tut66/Immersive-Design-Group-MIT-project/8 Motors V2/Read me.txt

2024-9-11 出现的问题
1. 电源输入的端子太细了，需要换接口，换成pin的那个双头的端子
2. 24-5V接电感的线没有连起来，24V和5V的LED灯的线都没有接
3. M4的M4A1接线没有接到焊盘上
