tut66/Immersive-Design-Group-MIT-project/8 Motors V2/Project Outputs for 8 Motors/8 Motors_BOM.xlsx

Comment | Description | Designator | Footprint | LibRef | Quantity | Supplier Part
10nF | 0603电容 | C1, C2, C3, C19, C20, C21, C37, C38 | C0603 | C0603_10nF | 8 | C100042
100nF | 0603电容 | C4, C5, C6, C7, C8, C9, C13, C17, C18, C22, C23, C24, C25, C26, C27, C34, C35, C36, C39, C40, C41, C42, C47, C48, C67, C71, C82, C83 | C0603 | C0603_100nF | 28 | C6119867
100uF | 贴片型铝电解电容 容值 100uF 精度 ±20% 额定电压 35V 纹波电流 87mA@120kHz | C10, C11, C12, C28, C29, C30, C43, C44 | SMD6.3_7.7_100uF | SMD6.3_7.7_100uF | 8 | C2836442
470nF | 0603电容 | C14, C15, C16, C31, C32, C33, C45, C46, C74 | C0603 | C0603_470nF | 9 | C1623
100nF | 0402电容 | C49, C51, C55, C56, C57, C58, C59, C60, C61, C62, C63, C64, C65, C66, C77, C79, C87 | C0402_2.2uF | C0402_100nF | 17 | C77020
10uF | 0402电容 | C50, C86 | C0402_2.2uF | C0402_10uF | 2 | C15525
22uF | 0603电容 | C52 | C0603 | C0603_22uF | 1 | C6119868
10pF | 0402电容 | C53, C54 | C0402_2.2uF | C0402_10pF | 2 | C1545
2.2uF | 容值 2.2uF 精度 ±20% 额定电压 6.3V 材质(温度系数) X5R | C68, C69 | C0402_2.2uF | C0402_2.2uF | 2 | C12530
4.7uF | 1206电容 | C70 | C1206 | C1206_4.7uF | 1 | C51205
2.2uF | 0603电容 | C72 | C0603 | C0603_2.2uF | 1 | C23630
15nF | 1206电容 | C73 | C1206 | C1206_15nF | 1 | C5186924
82pF | 0805电容 | C75 | C0805 | C0805_82pF | 1 | C527189
180uF | 贴片型铝电解电容 | C76 | SMD6.3_10_180uF | SMD6.3_10_180uF | 1 | C88141
10uF | 1206电容 | C78 | C1206 | C1206_10uF | 1 | C89632
10uF | 贴片型铝电解电容 | C80, C81 | SMD5_5.4_10uF | SMD5_5.4_10uF | 2 | C4747971
33nF | 0402电容 | C84 | C0402_2.2uF | C0402_33nF | 1 | C7419416
47uF | 1206电容 | C85 | C1206 | C1206_47uF | 1 | C6119973
#NAME? | 直插插针 | CN1, CN2, CN3, CN4, CN5, CN6, CN7, CN8 | ZX-XH2.54-4PZZ | ZX-XH2.54-4PZZ | 8 | C7429634
#NAME? | 直插插针 | CN9 | ZX-XH2.54-2PZZ | ZX-XH2.54-2PZZ | 1 | C7429632
#NAME? | 排针3P | H1, H2, H3, H4, H5, H6, H7, H8 | HC-1.25-3PLT | HC-1.25-3PLT | 8 | C2937625
#NAME? | 测试点 | H9, H10, H11 | Testpoint | Testpoint | 3 | C492400
#NAME? | 排针8P | H12 | HC-1.25-8PLT | HC-1.25-8PLT | 1 | C492421
22uH | 0603电感 | L1, L2 | L0603_22uH | L0603_22uH | 2 | C383393
3.3uH | 电感值 3.3uH 精度 ±20% 额定电流 16A 饱和电流(Isat) 22A 直流电阻(DCR) 6mΩ 类型 一体成型电感 | L3 | L1360 | L1360_3.3uH | 1 | C149526
10uH | 功率电感 | L4 | L1110_10uH | L1110_10uH | 1 | C497897
#NAME? | 发光二极管 绿色 | LED1, LED2_+24V, LED3_+5V, LED4_+3.3V | LED | LED | 4 | C389519
#NAME? | 1个N沟道 耐压:30V 电流:86A | Q1 | NMOS | NMOS | 1 | C81137
#NAME? | NMOS 漏源电压(Vdss) 60V 连续漏极电流(Id) 17A；100A 功率(Pd) 3.2W；116W 导通电阻(RDS(on)@Vgs,Id) 5.9mΩ@10V,18A | Q2 | CSD18533Q5A | CSD18533Q5A | 1 | C130170
1MΩ | 0603电阻 | R1, R2, R3, R16, R17, R18, R31, R32, R43 | R0603 | R0603_1MΩ | 9 | C22935
200mΩ | 1206电阻 | R4, R5, R6, R7, R8, R9, R19, R20, R21, R22, R23, R24, R33, R34, R35, R36 | R1206_200mΩ | R1206_200mΩ | 16 | C25335
10kΩ | 0603电阻 | R10, R11, R12, R25, R26, R27, R37, R38, R44, R45, R49, R51 | R0603_10KΩ | R0603_10KΩ | 12 | C25804
10kΩ | 可调电阻/电位器 阻值 10kΩ 精度 ±25% 额定电压 - 功率 150mW 温度系数 ±250ppm/℃ 圈数 1 | R13, R14, R15, R28, R29, R30, R39, R40 | R10k_KT | R10k_KT | 8 | C719176
0Ω | 阻值 0Ω 精度 ±1% 功率 100mW 最大工作电压 75V 工作温度范围 -55℃~+155℃ | R41, R42, R53, R54, R55 | R0603 | R0603_0Ω | 5 | C21189
2kΩ | 0603电阻 | R46 | R0603 | R0603_2KΩ | 1 | C22975
2.15kΩ | 0603电阻 | R47 | R0603 | R0603_2.15KΩ | 1 | C273772
140kΩ | 0805电阻 | R48 | R0805 | R0805_140KΩ | 1 | C17460
52.3kΩ | 0603电阻 | R50 | R0603_10KΩ | R0603_52.3KΩ | 1 | C2933235
4.7kΩ | 0603电阻 | R52 | R0603_10KΩ | R0603_4.7KΩ | 1 | C23162
10kΩ | 0603电阻 | R56 | R0603 | R0603_10KΩ | 1 | C25804
120Ω | 0603电阻 | R57 | R0603 | R0603_120Ω | 1 | C22787
20kΩ | 可调电阻，20K | RJ1 | R20k_KT | R20k_KT | 1 | C720648
#NAME? | 轻触开关 电路结构 单刀单掷 按钮形状 圆形按钮 作用力 2.5N 安装方式 立贴 开关长度 3.9mm 开关宽度 2.9mm 开关高度 2mm 带支架 不带 触点电流 50mA 额定电压(DC) 12V | SW1 | Switch | Switch | 1 | C843665
#NAME? | 步进电机驱动芯片 | U1, U2, U3, U4, U5, U6, U7, U8 | DRV8825PWPR | DRV8825PWPR | 8 | C81582
#NAME? | CPU内核：ARM-M4 程序存储容量：1MB RAM总容量：192KB GPIO端口数量：114 工作电压范围：1.8V~3.6V CPU最大主频：168MHz 程序存储器类型：FLASH 工作温度范围：-40℃~+85℃ ADC(位数)：12bit DAC(位数)：12bit | U9 | STM32F407ZGT6 | STM32F407ZGT6 | 1 | C19156
#NAME? | 卧式插头 | U10 | XT60PW-F | XT60PW-F | 1 | C428722
147kΩ | 0603电阻 | U11 | R0603 | R0603_147KΩ | 1 | C2998060
#NAME? | DC-DC电源芯片 功能类型 降压型 输入电压 6V~42V 输出电流 12A 开关频率 1MHz | U12 | LM3150MHX/NOPB | LM3150MHX/NOPB | 1 | C48112
#NAME? | 5V-3.3V | U13 | AMS1117-3.3 | AMS1117-3.3 | 1 | C6186
#NAME? | DCDC BUCK | U14 | TPS62932DRLR | TPS62932DRLR | 1 | C3032935
100kΩ | 0603电阻 | U15 | R0603 | R0603_100KΩ | 1 | C25803
#NAME? | CAN收发器 | U16 | SN65HVD230DR | SN65HVD230DR | 1 | C12084
#NAME? | ESD | U17, U18 | PESD0603-240 | PESD0603-240 | 2 | C2929617
8MHz | 8Mhz晶振 | X1 | Osc_8M | Osc_8M | 1 | C400090
