tut66/Immersive-Design-Group-MIT-project/8 Motors V2/8 Motors.pdf

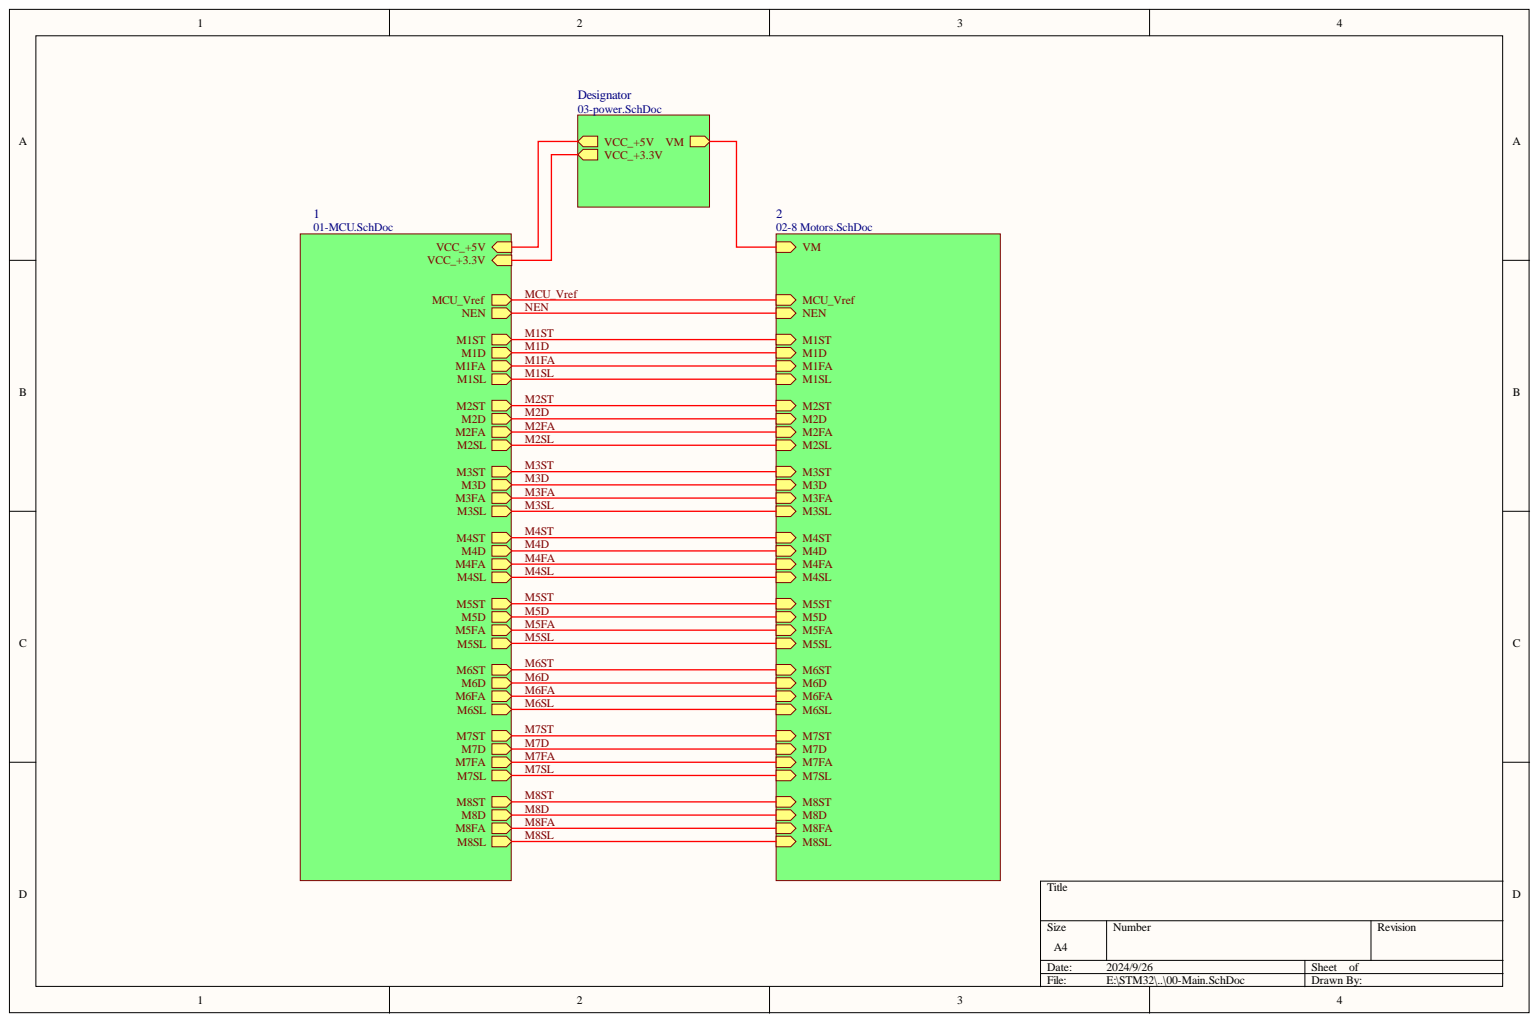
[picture p1: page 1]

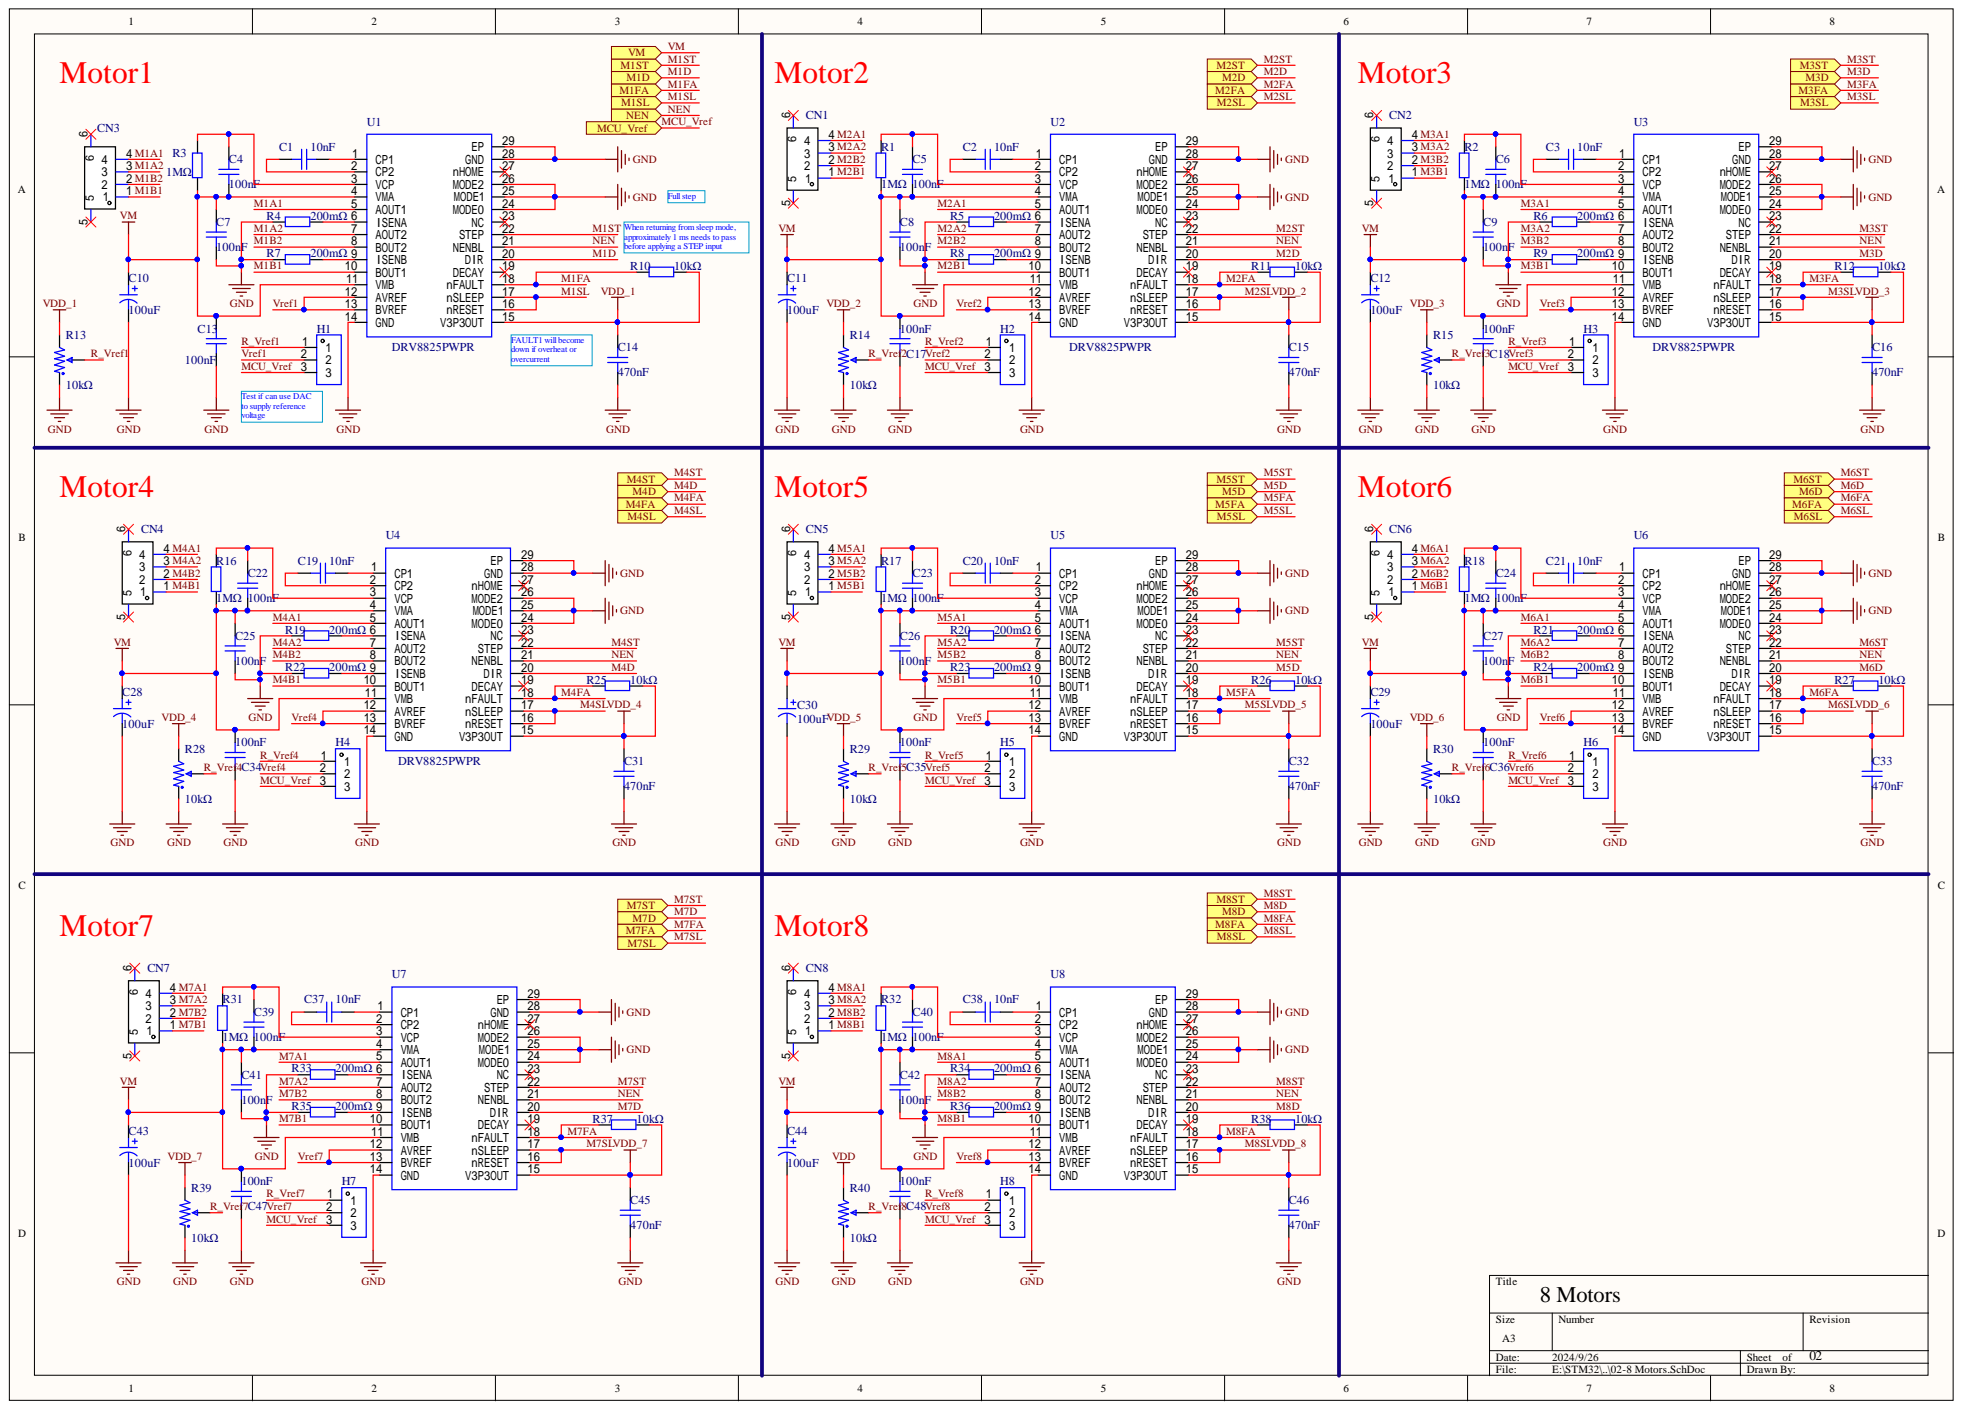
[picture p2: page 2]

1 R_Vref1 Vref1 MCU_Vref Test if can use DAC to supply reference voltage

M 7 F A | VDD_ 7

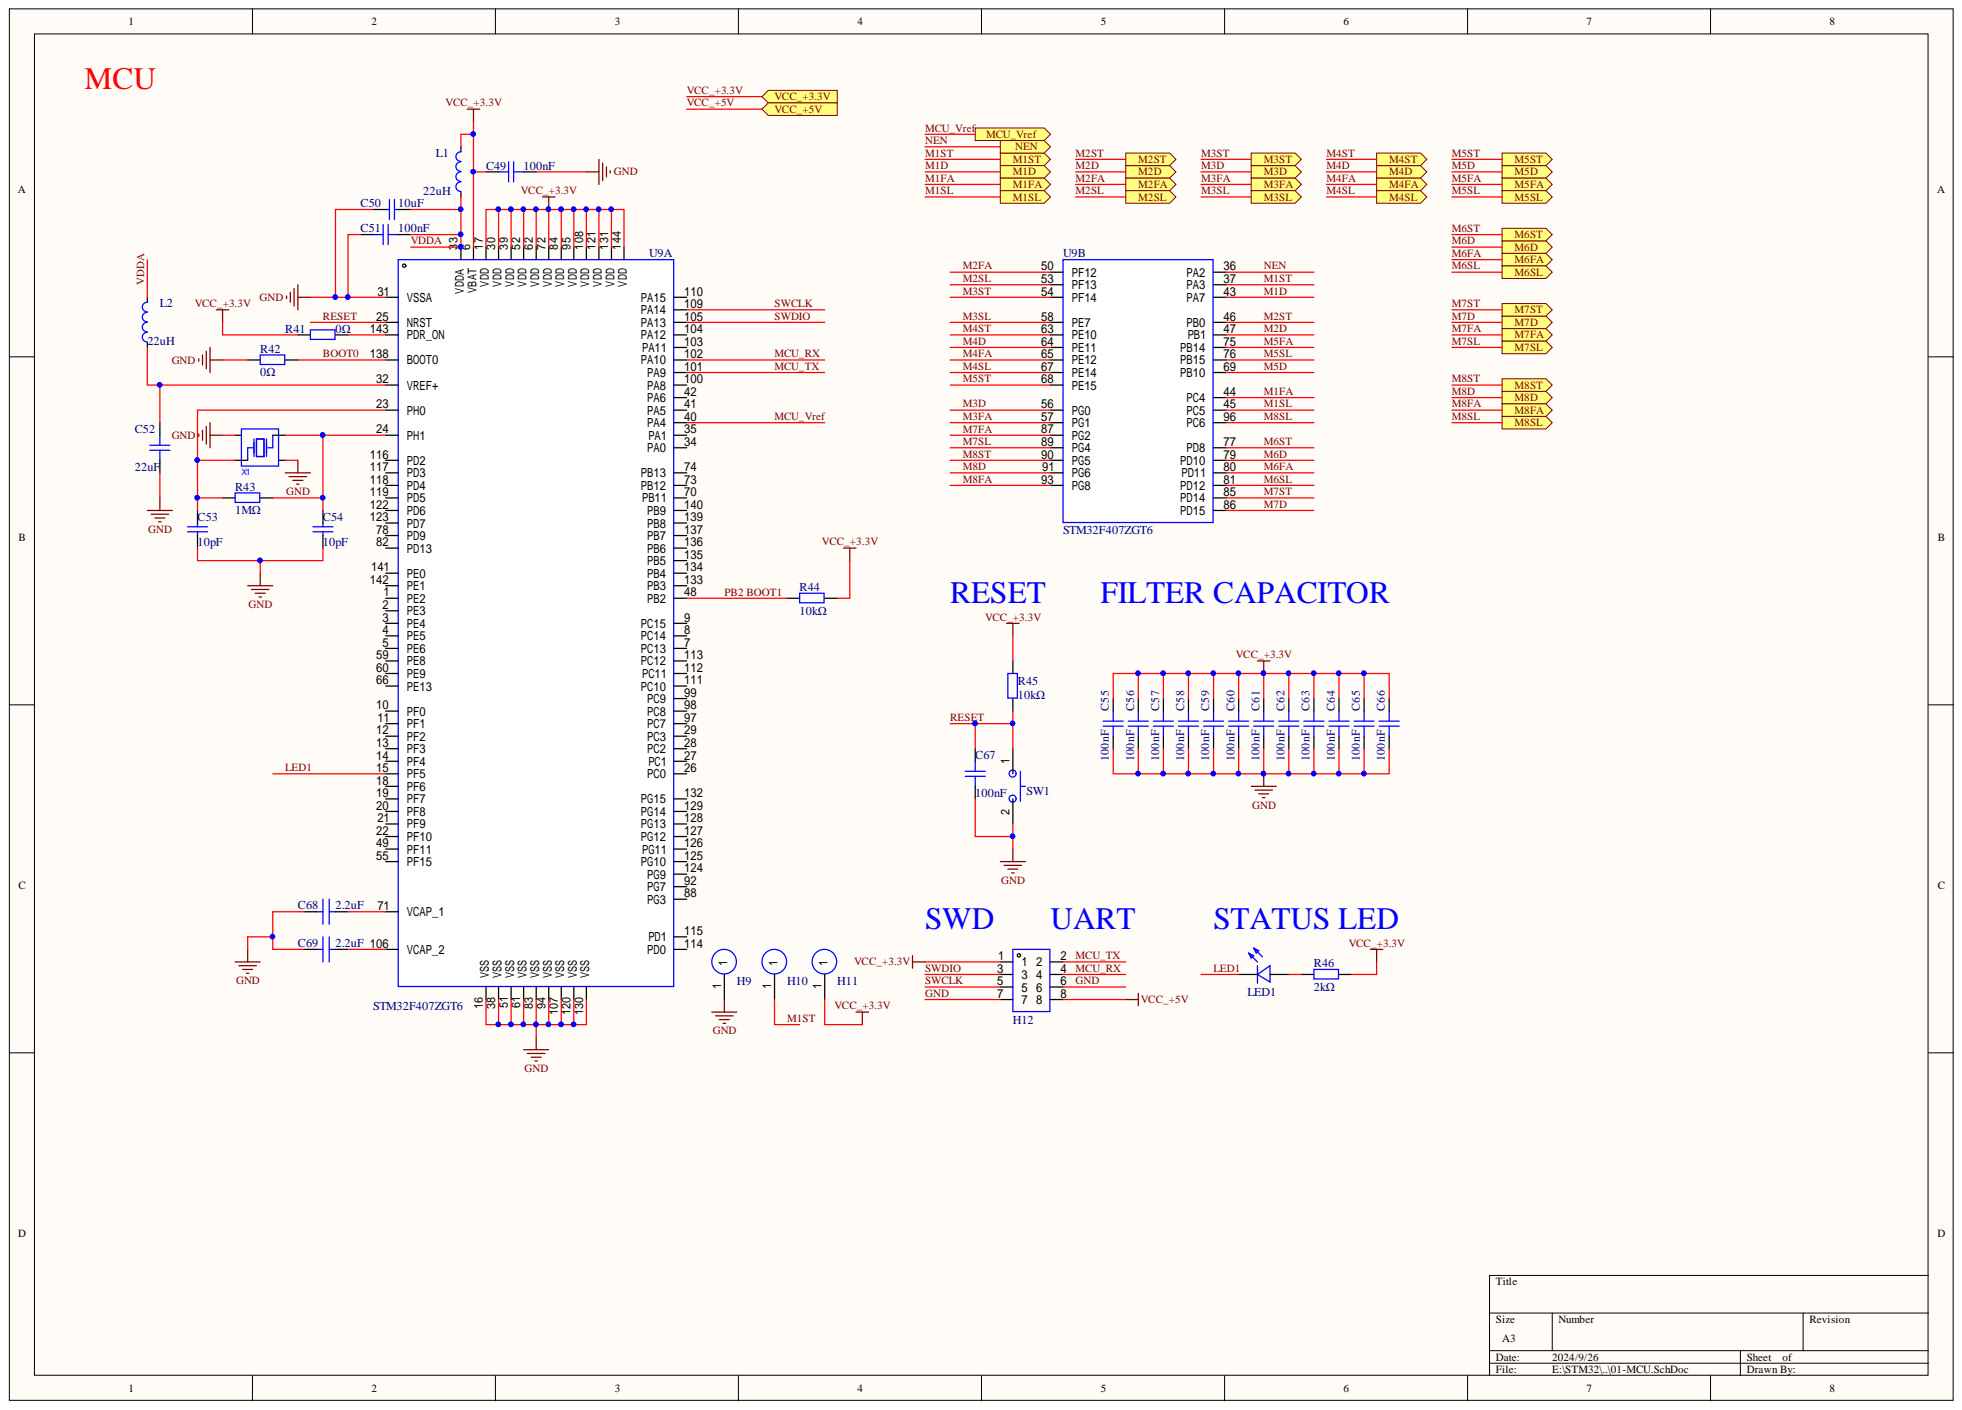
[picture p3: page 3]

GND R43

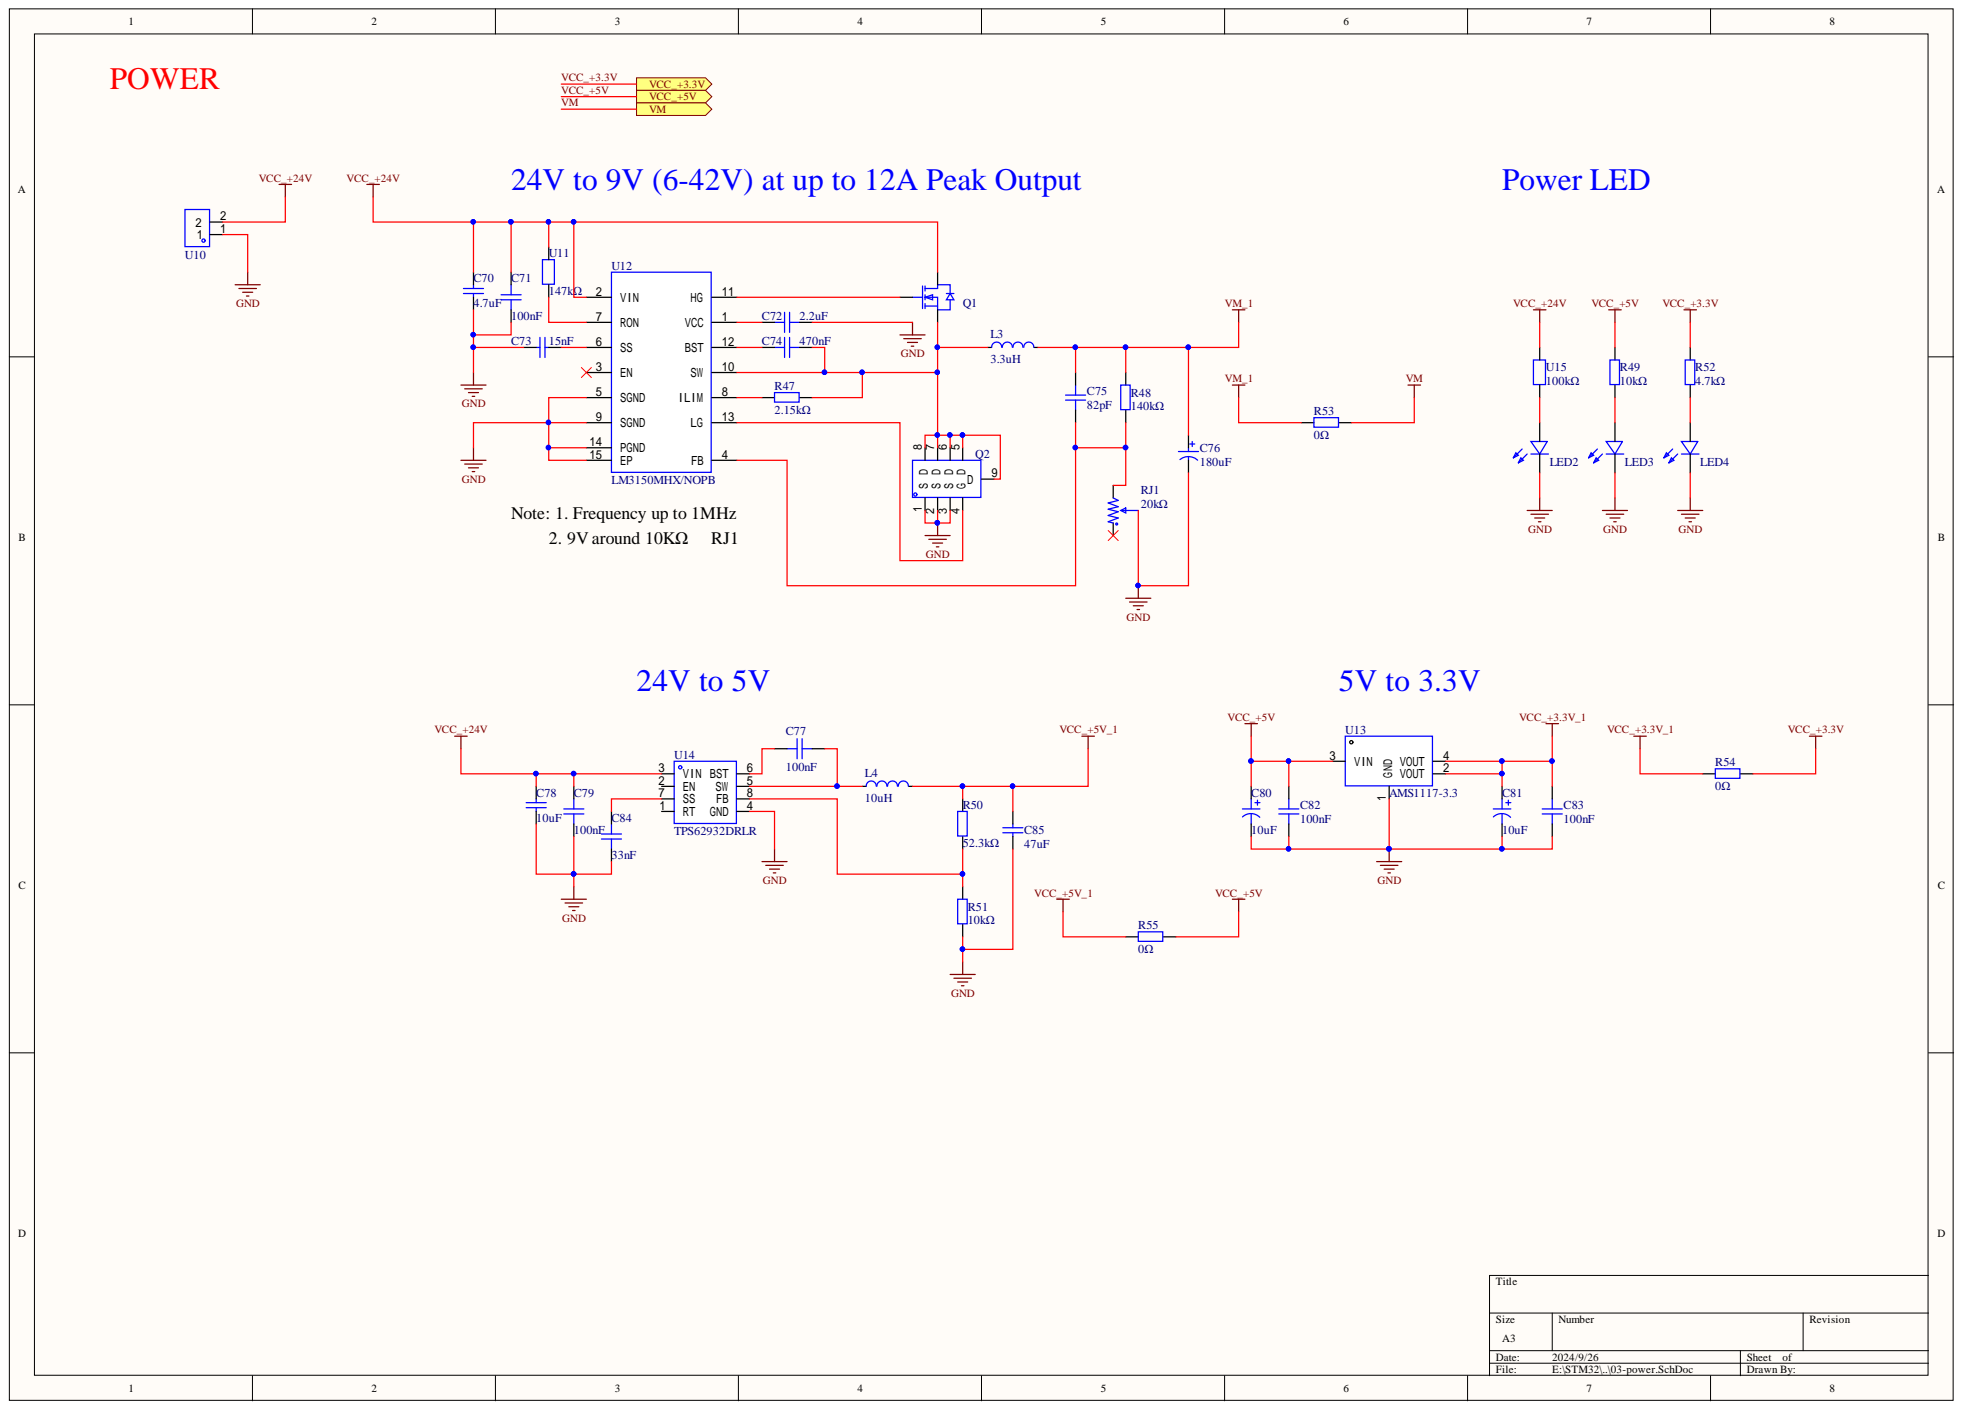
[picture p4: page 4]

24V to 9V (6-42V) at up to 12A Peak Output

GND
Note: 1. Frequency up to 1MHz

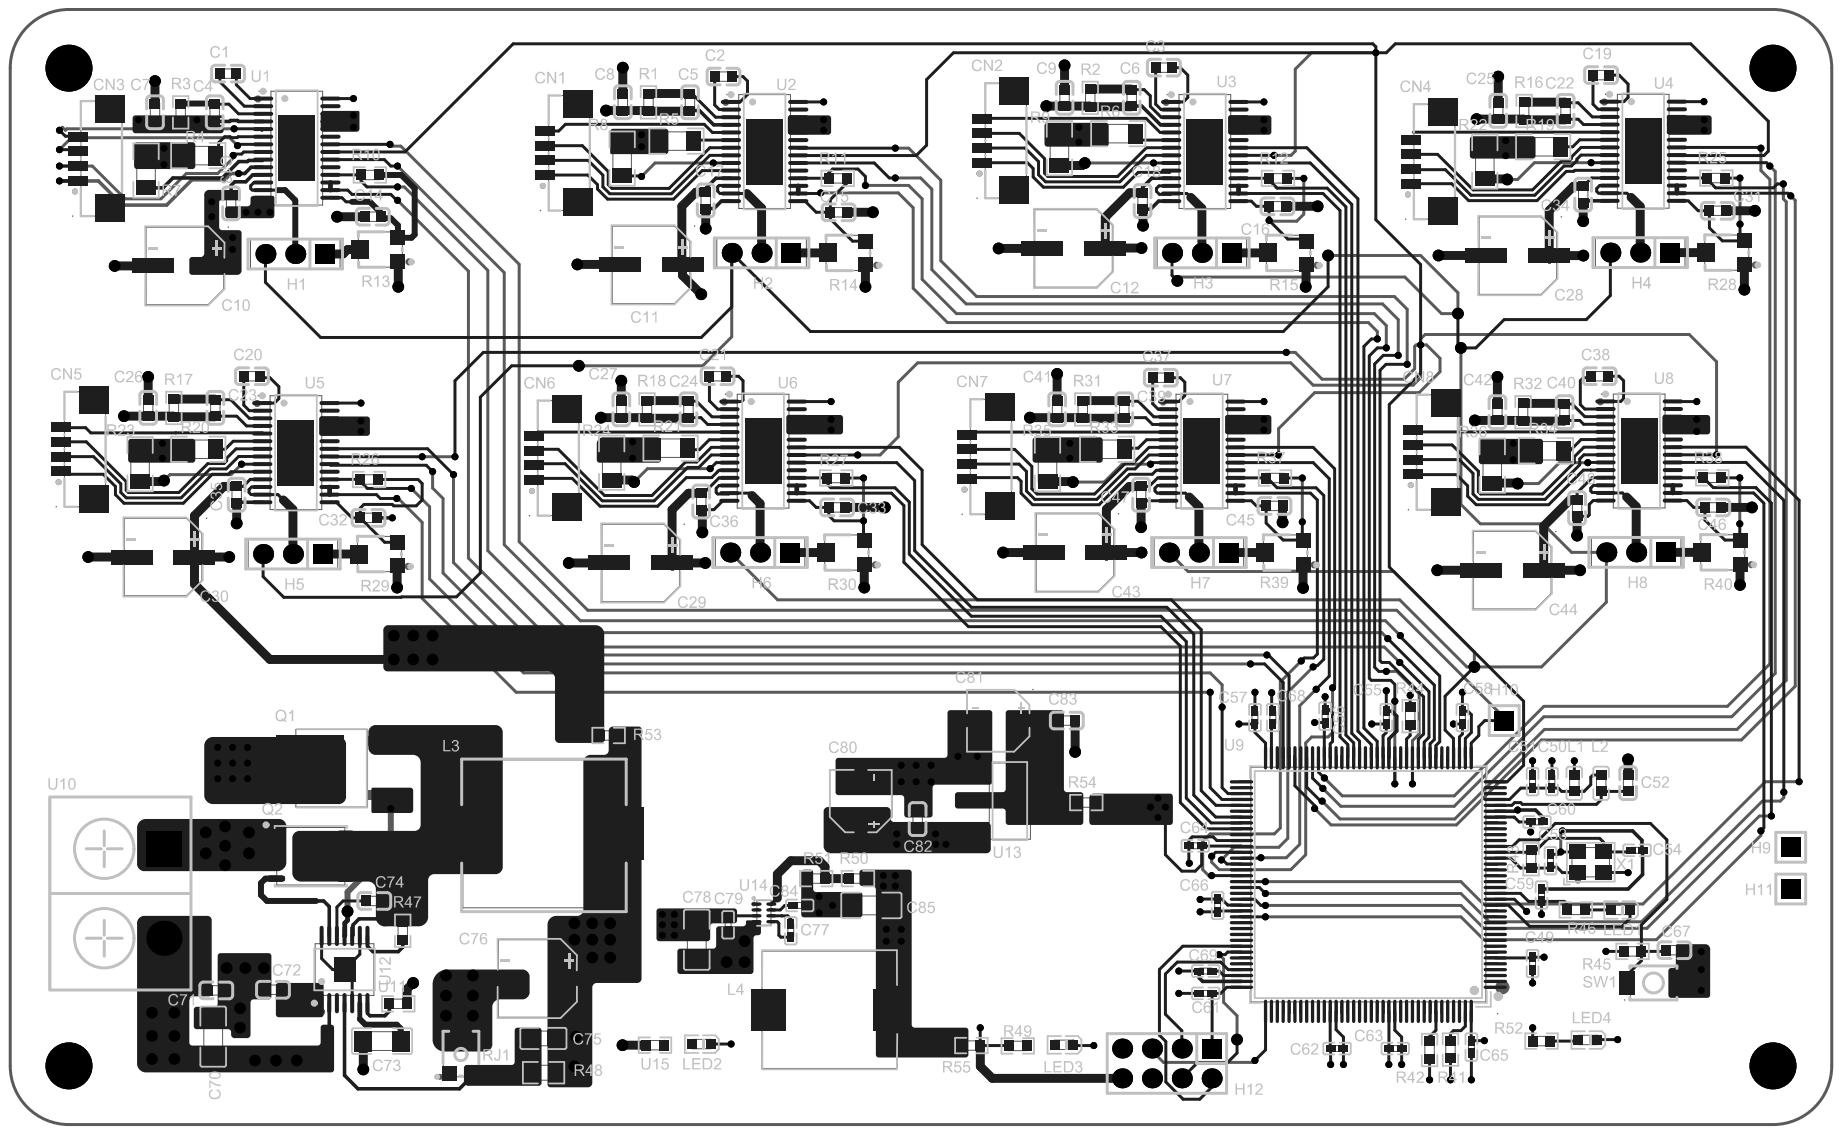
[picture p5: page 5]
