tut66/Immersive-Design-Group-MIT-project/(list of files, drawings)

Other design files:
8 Motors V2/00-Main.SchDoc
8 Motors V2/01-MCU.SchDoc
8 Motors V2/02-8 Motors.SchDoc
8 Motors V2/03-power.SchDoc
8 Motors V2/8 Motors.PcbDoc
8 Motors V2/8 Motors.PrjPcb
8 Motors V2/8 Motors_sch.SchDoc
8 Motors V2/JLC export/16SVPE180M1_16SVPE180M.schdoc
8 Motors V2/JLC export/0402CG100J500NT1_0402CG100J500NT.schdoc
8 Motors V2/JLC export/0603WAF0000T5E1_0603WAF0000T5E.schdoc
8 Motors V2/JLC export/0603WAF1002T5E1_0603WAF1002T5E.schdoc
8 Motors V2/JLC export/0603WAF1200T5E1_0603WAF1200T5E.schdoc
8 Motors V2/JLC export/0603WAF2001T5E1_0603WAF2001T5E.schdoc
8 Motors V2/JLC export/0805W8F1403T5E1_0805W8F1403T5E.schdoc
8 Motors V2/JLC export/1206W4F200LT5E1_1206W4F200LT5E.schdoc
8 Motors V2/JLC export/AMS1117-3.31_AMS1117-3.3.schdoc
8 Motors V2/JLC export/C0402.pcbdoc
8 Motors V2/JLC export/C0805.pcbdoc
8 Motors V2/JLC export/C1206.pcbdoc
8 Motors V2/JLC export/CAP-SMD_BD5.0-L5.3-W5.3-FD.pcbdoc
8 Motors V2/JLC export/CAP-SMD_BD6.3-L6.6-W6.6-LS7.3-FD.pcbdoc
8 Motors V2/JLC export/CAP-SMD_BD6.3-L6.6-W6.6-LS7.4-FD.pcbdoc
8 Motors V2/JLC export/CC0805FRNPO9BN8201_CC0805FRNPO9BN820.schdoc
8 Motors V2/JLC export/CL05A106MQ5NUNC1_CL05A106MQ5NUNC.schdoc
8 Motors V2/JLC export/CL05A225MQ5NSNC1_CL05A225MQ5NSNC.schdoc
8 Motors V2/JLC export/CL31B475KBHNNNE1_CL31B475KBHNNNE.schdoc
8 Motors V2/JLC export/CONN-SMD_4P-P1.25_HCTL_HC-1.25-4PLT.pcbdoc
8 Motors V2/JLC export/CONN-SMD_4P-P2.54_C9900012758.pcbdoc
8 Motors V2/JLC export/CONN-TH_2P-P2.50_HX25003-2A.pcbdoc
8 Motors V2/JLC export/CONN-TH_4P-P2.50_4PIN.pcbdoc
8 Motors V2/JLC export/CONN-TH_KF7.62-2P.pcbdoc
8 Motors V2/JLC export/CSD18533Q5A1_CSD18533Q5A.schdoc
8 Motors V2/JLC export/D0603-BI.pcbdoc
8 Motors V2/JLC export/DRV8428RTER1_DRV8428RTER.schdoc
8 Motors V2/JLC export/DRV8825PWPR1_DRV8825PWPR.schdoc
8 Motors V2/JLC export/FRC0603F1473TS1_FRC0603F1473TS.schdoc
8 Motors V2/JLC export/GRM155R71H104KE14D1_GRM155R71H104KE14D.schdoc
8 Motors V2/JLC export/GT-TC029B-H020-L1N1_GT-TC029B-H020-L1N.schdoc
8 Motors V2/JLC export/HC-1.25-4PLT1_HC-1.25-4PLT.schdoc
8 Motors V2/JLC export/HDR-TH_1P-P2.54-V-M.pcbdoc
8 Motors V2/JLC export/HDR-TH_3P-P2.54-V-M.pcbdoc
8 Motors V2/JLC export/HDR-TH_8P-P2.54-V-M-R2-C4-S2.54.pcbdoc
8 Motors V2/JLC export/HTSSOP-14_L5.0-W4.4-P0.65-LS6.4-BL-EP.pcbdoc
8 Motors V2/JLC export/HTSSOP-28_L9.7-W4.4-P0.65-LS6.4-BL-EP.pcbdoc
8 Motors V2/JLC export/IND-SMD_L11.5-W10.0_SMMS1040.pcbdoc
8 Motors V2/JLC export/IND-SMD_L11.5-W10.0_SMMS1040.PcbLib
8 Motors V2/JLC export/IND-SMD_L13.8-W12.6.pcbdoc
8 Motors V2/JLC export/IRLR8726TRPBF1_IRLR8726TRPBF.schdoc
8 Motors V2/JLC export/KF7.62-2P1_KF7.62-2P.schdoc
8 Motors V2/JLC export/L0603.pcbdoc
8 Motors V2/JLC export/LED0603-RD_GREEN.pcbdoc
8 Motors V2/JLC export/LM3150MHX1_LM3150MHX.schdoc
8 Motors V2/JLC export/LQFP-144_L20.0-W20.0-P0.50-LS22.0-BL.pcbdoc
8 Motors V2/JLC export/MHT192UGCT1_MHT192UGCT.schdoc
8 Motors V2/JLC export/MLZ1608M220WT0001_MLZ1608M220WT000.schdoc
8 Motors V2/JLC export/OSC-SMD_4P-L3.2-W2.5-BL.pcbdoc
8 Motors V2/JLC export/PESD0603-240_C29296171_PESD0603-240_C2929617.schdoc
8 Motors V2/JLC export/PQFN-8_L5.8-W4.9-P1.27-LS6.0-BL.pcbdoc
8 Motors V2/JLC export/PZ254V-11-01P1_PZ254V-11-01P.schdoc
8 Motors V2/JLC export/PZ254V-11-03P_C29376251_PZ254V-11-03P_C2937625.schdoc
8 Motors V2/JLC export/PZ254V-12-8P1_PZ254V-12-8P.schdoc
8 Motors V2/JLC export/QFN-30_L5.0-W5.0-P0.50-BL_XR76208XX.pcbdoc
8 Motors V2/JLC export/R0603.pcbdoc
8 Motors V2/JLC export/R0805.pcbdoc
8 Motors V2/JLC export/R1206.pcbdoc
8 Motors V2/JLC export/RES-ADJ-SMD_3P-L3.0-W3.8-P1.75-BR.pcbdoc
8 Motors V2/JLC export/RES-ADJ-SMD_TC33X-2-104E.pcbdoc
8 Motors V2/JLC export/RST10UF50V0161_RST10UF50V016.schdoc
8 Motors V2/JLC export/RVT100UF35V67RV00341_RVT100UF35V67RV0034.schdoc
8 Motors V2/JLC export/SMD-8_L2.1-W1.2-P0.50-LS1.6-BL.pcbdoc
8 Motors V2/JLC export/SMMS1360-3R3M1_SMMS1360-3R3M.schdoc
8 Motors V2/JLC export/SN65HVD230DR1_SN65HVD230DR.schdoc
8 Motors V2/JLC export/SOIC-8_L4.9-W3.9-P1.27-LS6.0-BL.pcbdoc
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
